daglem/reDIP-64/hardware/reDIP-64.kicad_pcb

## KiCad design hardware/reDIP-64.kicad_pcb (2024-03-09)

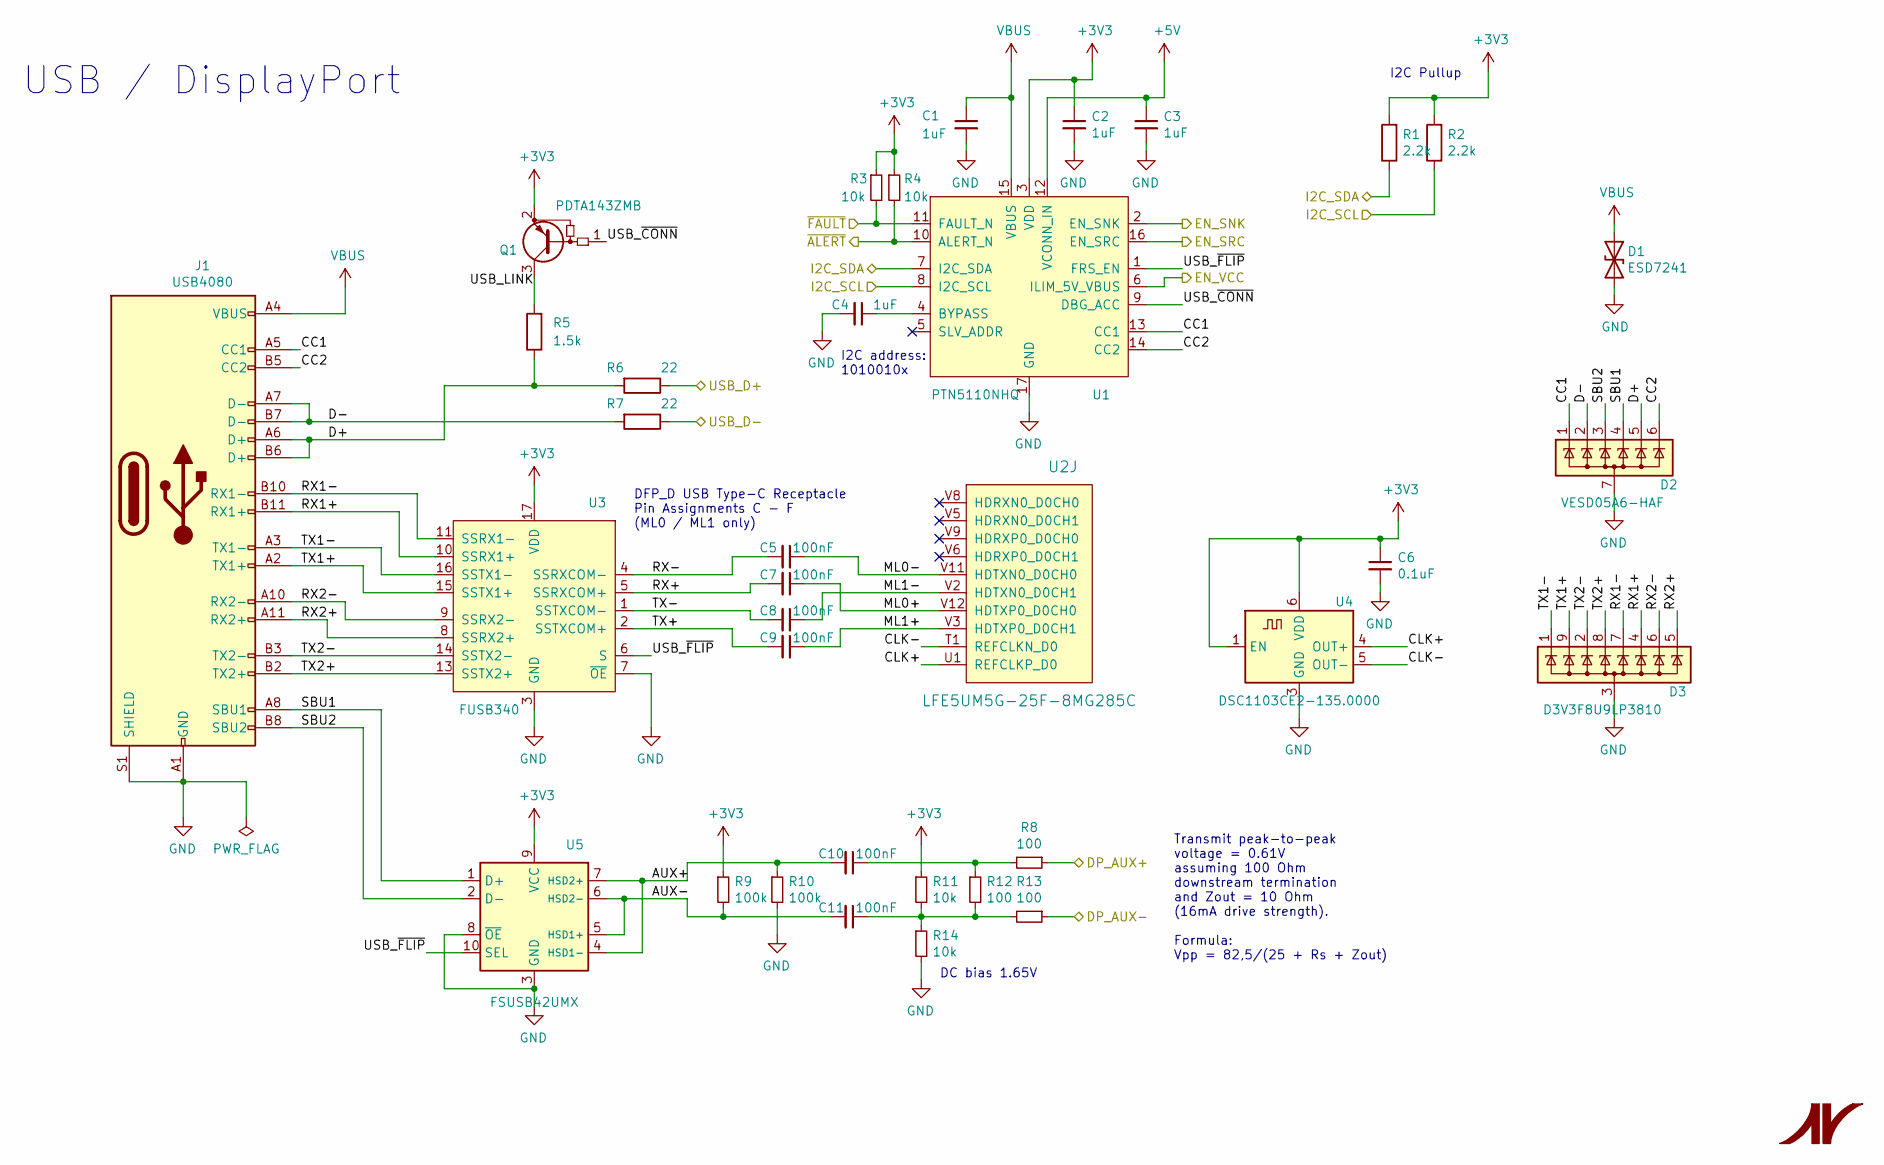
[picture p1: schematic reDIP-64-USB.kicad_sch, reDIP 64]

Parts:
C1: 1uF; C_0402_1005Metric
C2, C3, C4: 1uF; C_0201_0603Metric
C5, C7, C8, C9, C10, C11: 100nF; C_0201_0603Metric
C6: 0.1uF; C_0201_0603Metric
D1: ESD7241; CASE_714AB_1.0x0.6mm
D2: VESD05A6-HAF; LLP75-7L
D3: D3V3F8U9LP3810; U-DFN3810-9
J1: USB4080; USB_C_Receptacle_GCT_USB4080
Q1: PDTA143ZMB; SOT-883
R1, R2: 2.2k; R_0201_0603Metric
R3, R4, R11, R14: 10k; R_0201_0603Metric
R5: 1.5k; R_0201_0603Metric
R6, R7: 22; R_0201_0603Metric
R8, R12, R13: 100; R_0201_0603Metric
R9, R10: 100k; R_0201_0603Metric
U1: PTN5110NHQ; SOT-1883-1
U2: LFE5UM5G-25F-8MG285C; BGA-285_10x10mm_P0.5mm
U3: FUSB340; CASE_722AB_2.0x2.8mm_P0.4mm
U4: DSC1103CE2-135.0000; Oscillator_SMD_3225-6Pin_3.2x2.5mm
U5: FSUSB42UMX; CASE_523BC_1.4x1.8_P0.4mm

Connections:
+3V3: C2.1, C6.1, Q1.2 (E), R1.2, R2.2, R3.1, R4.1, R9.1, R11.1, U1.3 (VDD), U3.17 (VDD), U4.1 (EN), U4.6 (VDD), U5.9 (VCC); also elsewhere on the board
+5V: C3.1, U1.12 (VCONN_IN); also elsewhere on the board
/Audio/I2C_SCL: R2.1, U1.8 (I2C_SCL); also elsewhere on the board
/Audio/I2C_SDA: R1.1, U1.7 (I2C_SDA); also elsewhere on the board
/FPGA_IO/DP_AUX+: R8.1; also elsewhere on the board
/FPGA_IO/DP_AUX-: R13.1; also elsewhere on the board
/FPGA_IO/USB_D+: R6.1; also elsewhere on the board
/FPGA_IO/USB_D-: R7.1; also elsewhere on the board
/FPGA_IO/~ALERT: R4.2, U1.10 (ALERT_N); also elsewhere on the board
/Power/EN_SNK: U1.2 (EN_SNK); also elsewhere on the board
/Power/EN_SRC: U1.16 (EN_SRC); also elsewhere on the board
/Power/EN_VCC: U1.6 (ILIM_5V_VBUS); also elsewhere on the board
/Power/~FAULT: R3.2, U1.11 (FAULT_N); also elsewhere on the board
/USB_DisplayPort/AUX+: C10.2, R10.1, U5.4 (HSD1-), U5.7 (HSD2+)
/USB_DisplayPort/AUX-: C11.2, R9.2, U5.5 (HSD1+), U5.6 (HSD2-)
/USB_DisplayPort/CC1: D2.1 (K), J1.A5 (CC1), U1.13 (CC1)
/USB_DisplayPort/CC2: D2.6 (K), J1.B5 (CC2), U1.14 (CC2)
/USB_DisplayPort/CLK+: U2.U1 (REFCLKP_D0), U4.4 (OUT+)
/USB_DisplayPort/CLK-: U2.T1 (REFCLKN_D0), U4.5 (OUT-)
/USB_DisplayPort/D+: D2.5 (K), J1.A6 (D+), J1.B6 (D+), R5.1, R6.2
/USB_DisplayPort/D-: D2.2 (K), J1.A7 (D-), J1.B7 (D-), R7.2
/USB_DisplayPort/ML0+: C7.1, U2.V12 (HDTXP0_D0CH0)
/USB_DisplayPort/ML0-: C5.1, U2.V11 (HDTXN0_D0CH0)
/USB_DisplayPort/ML1+: C9.1, U2.V3 (HDTXP0_D0CH1)
/USB_DisplayPort/ML1-: C8.1, U2.V2 (HDTXN0_D0CH1)
/USB_DisplayPort/RX1+: D3.4 (Line-6), J1.B11 (RX1+), U3.10 (SSRX1+)
/USB_DisplayPort/RX1-: D3.7 (Line-5), J1.B10 (RX1-), U3.11 (SSRX1-)
/USB_DisplayPort/RX2+: D3.5 (Line-8), J1.A11 (RX2+), U3.8 (SSRX2+)
/USB_DisplayPort/RX2-: D3.6 (Line-7), J1.A10 (RX2-), U3.9 (SSRX2-)
/USB_DisplayPort/RX+: C7.2, U3.5 (SSRXCOM+)
/USB_DisplayPort/RX-: C5.2, U3.4 (SSRXCOM-)
/USB_DisplayPort/SBU1: D2.4 (K), J1.A8 (SBU1), U5.1 (D+)
/USB_DisplayPort/SBU2: D2.3 (K), J1.B8 (SBU2), U5.2 (D-)
/USB_DisplayPort/TX1+: D3.9 (Line-2), J1.A2 (TX1+), U3.15 (SSTX1+)
/USB_DisplayPort/TX1-: D3.1 (Line-1), J1.A3 (TX1-), U3.16 (SSTX1-)
/USB_DisplayPort/TX2+: D3.8 (Line-4), J1.B2 (TX2+), U3.13 (SSTX2+)
/USB_DisplayPort/TX2-: D3.2 (Line-3), J1.B3 (TX2-), U3.14 (SSTX2-)
/USB_DisplayPort/TX+: C9.2, U3.2 (SSTXCOM+)
/USB_DisplayPort/TX-: C8.2, U3.1 (SSTXCOM-)
/USB_DisplayPort/USB_LINK: Q1.3 (C), R5.2
/USB_DisplayPort/USB_~CONN: Q1.1 (B), U1.9 (DBG_ACC)
/USB_DisplayPort/USB_~FLIP: U1.1 (FRS_EN), U3.6 (S), U5.10 (SEL)
GND: C1.2, C2.2, C3.2, C4.2, C6.2, D1.2 (A2), D2.7 (GND), D3.3 (GND), J1.A1 (GND), J1.A12 (GND), J1.B1 (GND), J1.B12 (GND), J1.S1 (SHIELD), R10.2, R14.2, U1.17 (GND), U3.3 (GND), U3.7 (~OE), U3.12 (GND), U3.18 (GND), U3.19 (GND), U4.3 (GND), U5.3 (GND), U5.8 (~OE); also elsewhere on the board
unnamed: C10.1, R8.2, R12.1
unnamed: C11.1, R11.2, R12.2, R13.2, R14.1
unnamed: C4.1, U1.4 (BYPASS)
VBUS: C1.1, D1.1 (A1), J1.A4 (VBUS), J1.A9 (VBUS), J1.B4 (VBUS), J1.B9 (VBUS), U1.15 (VBUS); also elsewhere on the board

Notes on the sheet:
Transmit peak-to-peak voltage = 0.61V assuming 100 Ohm downstream termination and Zout = 10 Ohm (16mA drive strength). Formula: Vpp = 82,5/(25 + Rs + Zout)
USB / DisplayPort
DFP_D USB Type-C Receptacle Pin Assignments C - F (ML0 / ML1 only)
DC bias 1.65V
I2C address: 1010010x
I2C Pullup

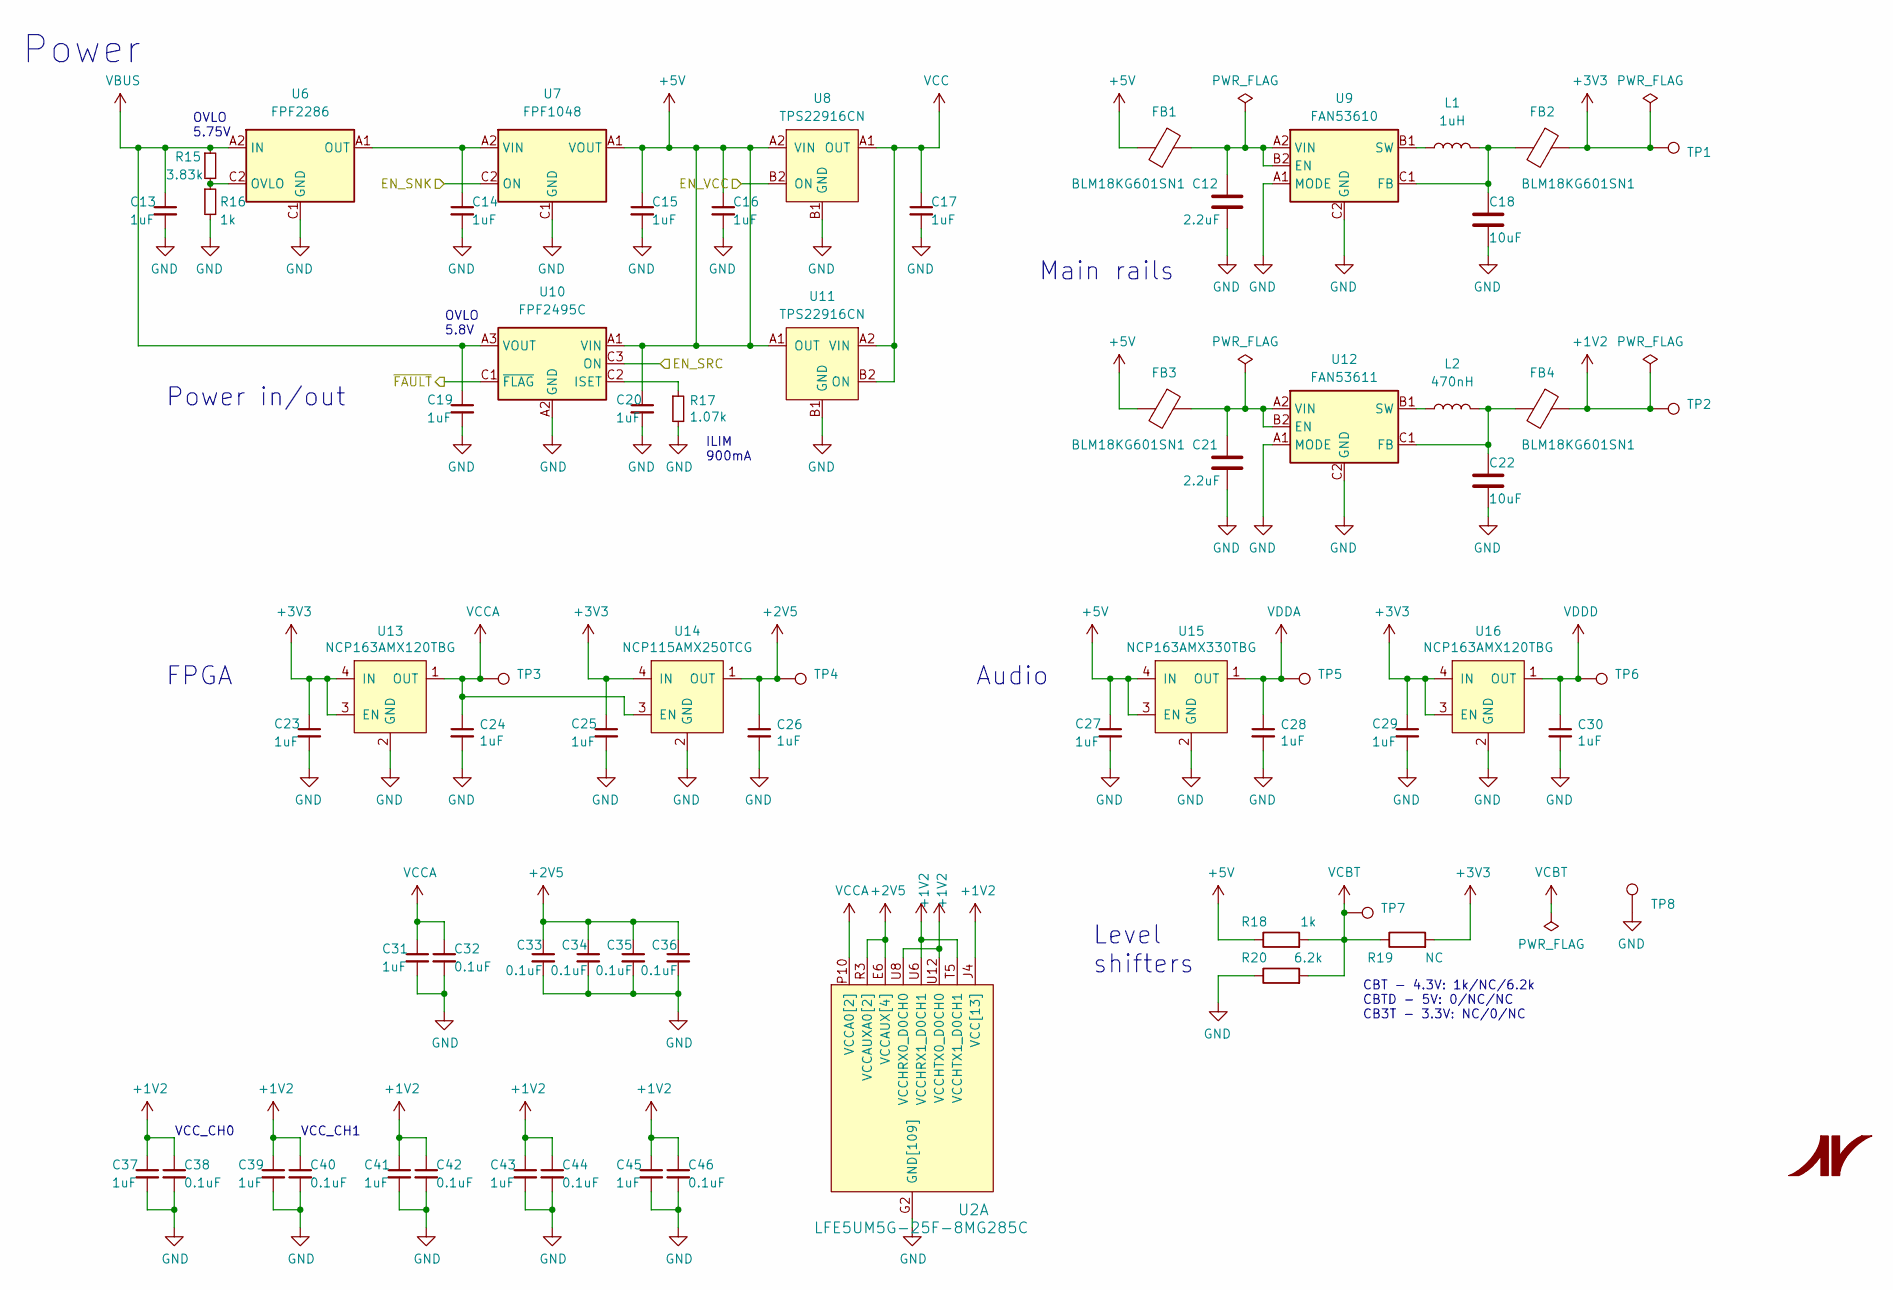
[picture p2: schematic reDIP-64-Power.kicad_sch, reDIP 64]

Parts:
C12, C21: 2.2uF; C_0402_1005Metric
C13, C14, C15, C16, C17, C19, C20, C27: 1uF; C_0402_1005Metric
C18: 10uF; C_0603_1608Metric
C22: 10uF; C_0402_1005Metric
C23, C24, C25, C26, C28, C29, C30, C31, C37, C39, C41, C43, C45: 1uF; C_0201_0603Metric
C32, C33, C34, C35, C36, C38, C40, C42, C44, C46: 0.1uF; C_0201_0603Metric
FB1, FB2, FB3, FB4: BLM18KG601SN1; L_0603_1608Metric
L1: 1uH; L_0603_1608Metric
L2: 470nH; L_0603_1608Metric
R15: 3.83k; R_0201_0603Metric
R16, R18: 1k; R_0201_0603Metric
R17: 1.07k; R_0201_0603Metric
R19: NC; R_0201_0603Metric
R20: 6.2k; R_0201_0603Metric
TP1, TP2, TP3, TP4, TP5, TP6, TP7, TP8: TestPoint; TestPoint_Pad_D0.5mm
U2: LFE5UM5G-25F-8MG285C; BGA-285_10x10mm_P0.5mm
U6: FPF2286; CASE_567UV_1.30x0.90mm_P0.4mm
U7: FPF1048; CASE_567RM_1.46x0.96mm_P0.5mm
U8, U11: TPS22916CN; Texas_DSBGA-4_0.78x0.78mm_Layout2x2_P0.4mm
U9: FAN53610; CASE_567RQ_1.16x0.86mm_P0.4mm
U10: FPF2495C; CASE_567RV_1.21x1.21mm_P0.4mm
U12: FAN53611; CASE_567RQ_1.16x0.86mm_P0.4mm
U13, U16: NCP163AMX120TBG; CASE_711AJ_1.0x1.0mm_P0.65mm
U14: NCP115AMX250TCG; CASE_711AJ_1.0x1.0mm_P0.65mm
U15: NCP163AMX330TBG; CASE_711AJ_1.0x1.0mm_P0.65mm

Connections:
+1V2: C37.1, C38.1, C39.1, C40.1, C41.1, C42.1, C43.1, C44.1, C45.1, C46.1, FB4.1, TP2.1, U2.D8 (VCC[13]), U2.D9 (VCC[13]), U2.D10 (VCC[13]), U2.D11 (VCC[13]), U2.J4 (VCC[13]), U2.J5 (VCC[13]), U2.J14 (VCC[13]), U2.J15 (VCC[13]), U2.M4 (VCC[13]), U2.M15 (VCC[13]), U2.P7 (VCC[13]), U2.P9 (VCC[13]), U2.P11 (VCC[13]), U2.T5 (VCCHTX1_D0CH1), U2.U6 (VCCHRX1_D0CH1), U2.U8 (VCCHRX0_D0CH0), U2.U12 (VCCHTX0_D0CH0)
+2V5: C26.1, C33.1, C34.1, C35.1, C36.1, TP4.1, U2.E6 (VCCAUX[4]), U2.E13 (VCCAUX[4]), U2.N6 (VCCAUX[4]), U2.P5 (VCCAUXA0[2]), U2.P13 (VCCAUX[4]), U2.R3 (VCCAUXA0[2]), U14.1 (OUT)
+3V3: C23.1, C25.1, C29.1, FB2.1, R19.2, TP1.1, U13.3 (EN), U13.4 (IN), U14.4 (IN), U16.3 (EN), U16.4 (IN); also elsewhere on the board
+5V: C15.1, C16.1, C20.1, C27.1, FB1.2, FB3.2, R18.1, U7.A1 (VOUT), U7.B1 (VOUT), U8.A2 (VIN), U10.A1 (VIN), U10.B1 (VIN), U11.A1 (OUT), U15.3 (EN), U15.4 (IN); also elsewhere on the board
/Power/EN_SNK: U7.C2 (ON); also elsewhere on the board
/Power/EN_SRC: U10.C3 (ON); also elsewhere on the board
/Power/EN_VCC: U8.B2 (ON); also elsewhere on the board
/Power/~FAULT: U10.C1 (~FLAG); also elsewhere on the board
GND: C12.2, C13.2, C14.2, C15.2, C16.2, C17.2, C18.2, C19.2, C20.2, C21.2, C22.2, C23.2, C24.2, C25.2, C26.2, C27.2, C28.2, C29.2, C30.2, C31.2, C32.2, C33.2, C34.2, C35.2, C36.2, C37.2, C38.2, C39.2, C40.2, C41.2, C42.2, C43.2, C44.2, C45.2, C46.2, R16.2, R17.2, R20.1, TP8.1, U2.B3 (GND[109]), U2.B16 (GND[109]), U2.E5 (GND[109]), U2.E7 (GND[109]), U2.E8 (GND[109]), U2.E9 (GND[109]), U2.E10 (GND[109]), U2.E11 (GND[109]), U2.E12 (GND[109]), U2.E14 (GND[109]), U2.F5 (GND[109]), U2.F6 (GND[109]), U2.F7 (GND[109]), U2.F8 (GND[109]), U2.F9 (GND[109]), U2.F10 (GND[109]), U2.F11 (GND[109]), U2.F12 (GND[109]), U2.F13 (GND[109]), U2.F14 (GND[109]), U2.G2 (GND[109]), U2.G6 (GND[109]), U2.G7 (GND[109]), U2.G8 (GND[109]), U2.G9 (GND[109]), U2.G10 (GND[109]), U2.G11 (GND[109]), U2.G12 (GND[109]), U2.G13 (GND[109]), U2.G17 (GND[109]), U2.H6 (GND[109]), U2.H7 (GND[109]), U2.H8 (GND[109]), U2.H9 (GND[109]), U2.H10 (GND[109]), U2.H11 (GND[109]), U2.H12 (GND[109]), U2.H13 (GND[109]), U2.J6 (GND[109]), U2.J7 (GND[109]), U2.J8 (GND[109]), U2.J9 (GND[109]), U2.J10 (GND[109]), U2.J11 (GND[109]), U2.J12 (GND[109]), U2.J13 (GND[109]), U2.K5 (GND[109]), U2.K6 (GND[109]), U2.K7 (GND[109]), U2.K8 (GND[109]), U2.K9 (GND[109]), U2.K10 (GND[109]), U2.K11 (GND[109]), U2.K12 (GND[109]), U2.K13 (GND[109]), U2.K14 (GND[109]), U2.L2 (GND[109]), U2.L5 (GND[109]), U2.L6 (GND[109]), U2.L7 (GND[109]), U2.L8 (GND[109]), U2.L9 (GND[109]), U2.L10 (GND[109]), U2.L11 (GND[109]), U2.L12 (GND[109]), U2.L13 (GND[109]), U2.L14 (GND[109]), U2.L17 (GND[109]), U2.M6 (GND[109]), U2.M7 (GND[109]), U2.M8 (GND[109]), U2.M9 (GND[109]), U2.M10 (GND[109]), U2.M11 (GND[109]), U2.M12 (GND[109]), U2.M13 (GND[109]), U2.N7 (GND[109]), U2.N8 (GND[109]), U2.N9 (GND[109]), U2.N10 (GND[109]), U2.N11 (GND[109]), U2.N12 (GND[109]), U2.P6 (GND[109]), U2.P8 (GND[109]), U2.P12 (GND[109]), U2.R1 (GND[109]), U2.R2 (GND[109]), U2.T2 (GND[109]), U2.T3 (GND[109]), U2.T4 (GND[109]), U2.T6 (GND[109]), U2.T7 (GND[109]), U2.T8 (GND[109]), U2.T9 (GND[109]), U2.T10 (GND[109]), U2.T11 (GND[109]), U2.T12 (GND[109]), U2.T16 (GND[109]), U2.U2 (GND[109]), U2.U3 (GND[109]), U2.U4 (GND[109]), U2.U5 (GND[109]), U2.U7 (GND[109]), U2.U9 (GND[109]), U2.U10 (GND[109]), U2.U11 (GND[109]), U2.V4 (GND[109]), U2.V7 (GND[109]), U2.V10 (GND[109]), U6.C1 (GND), U7.C1 (GND), U8.B1 (GND), U9.A1 (MODE), U9.C2 (GND), U10.A2 (GND), U10.B2 (GND), U11.B1 (GND), U12.A1 (MODE), U12.C2 (GND), U13.2 (GND), U14.2 (GND), U15.2 (GND), U16.2 (GND); also elsewhere on the board
unnamed: C14.1, U6.A1 (OUT), U6.B1 (OUT), U7.A2 (VIN), U7.B2 (VIN)
unnamed: R15.2, R16.1, U6.C2 (OVLO)
unnamed: C12.1, FB1.1, U9.A2 (VIN), U9.B2 (EN)
unnamed: C18.1, FB2.2, L1.2, U9.C1 (FB)
unnamed: L1.1, U9.B1 (SW)
unnamed: R17.1, U10.C2 (ISET)
unnamed: C21.1, FB3.1, U12.A2 (VIN), U12.B2 (EN)
unnamed: C22.1, FB4.2, L2.2, U12.C1 (FB)
unnamed: L2.1, U12.B1 (SW)
VBUS: C13.1, C19.1, R15.1, U6.A2 (IN), U6.B2 (IN), U10.A3 (VOUT), U10.B3 (VOUT); also elsewhere on the board
VCBT: R18.2, R19.1, R20.2, TP7.1; also elsewhere on the board
VCC: C17.1, U8.A1 (OUT), U11.A2 (VIN), U11.B2 (ON); also elsewhere on the board
VCCA: C24.1, C31.1, C32.1, TP3.1, U2.P10 (VCCA0[2]), U2.R10 (VCCA0[2]), U13.1 (OUT), U14.3 (EN)
VDDA: C28.1, TP5.1, U15.1 (OUT); also elsewhere on the board
VDDD: C30.1, TP6.1, U16.1 (OUT); also elsewhere on the board

Notes on the sheet:
OVLO 5.8V
Power
VCC_CH1
CBT - 4.3V: 1k/NC/6.2k CBTD - 5V: 0/NC/NC CB3T - 3.3V: NC/0/NC
OVLO 5.75V
ILIM 900mA
VCC_CH0
Power in/out
Audio
FPGA
Main rails
Level shifters

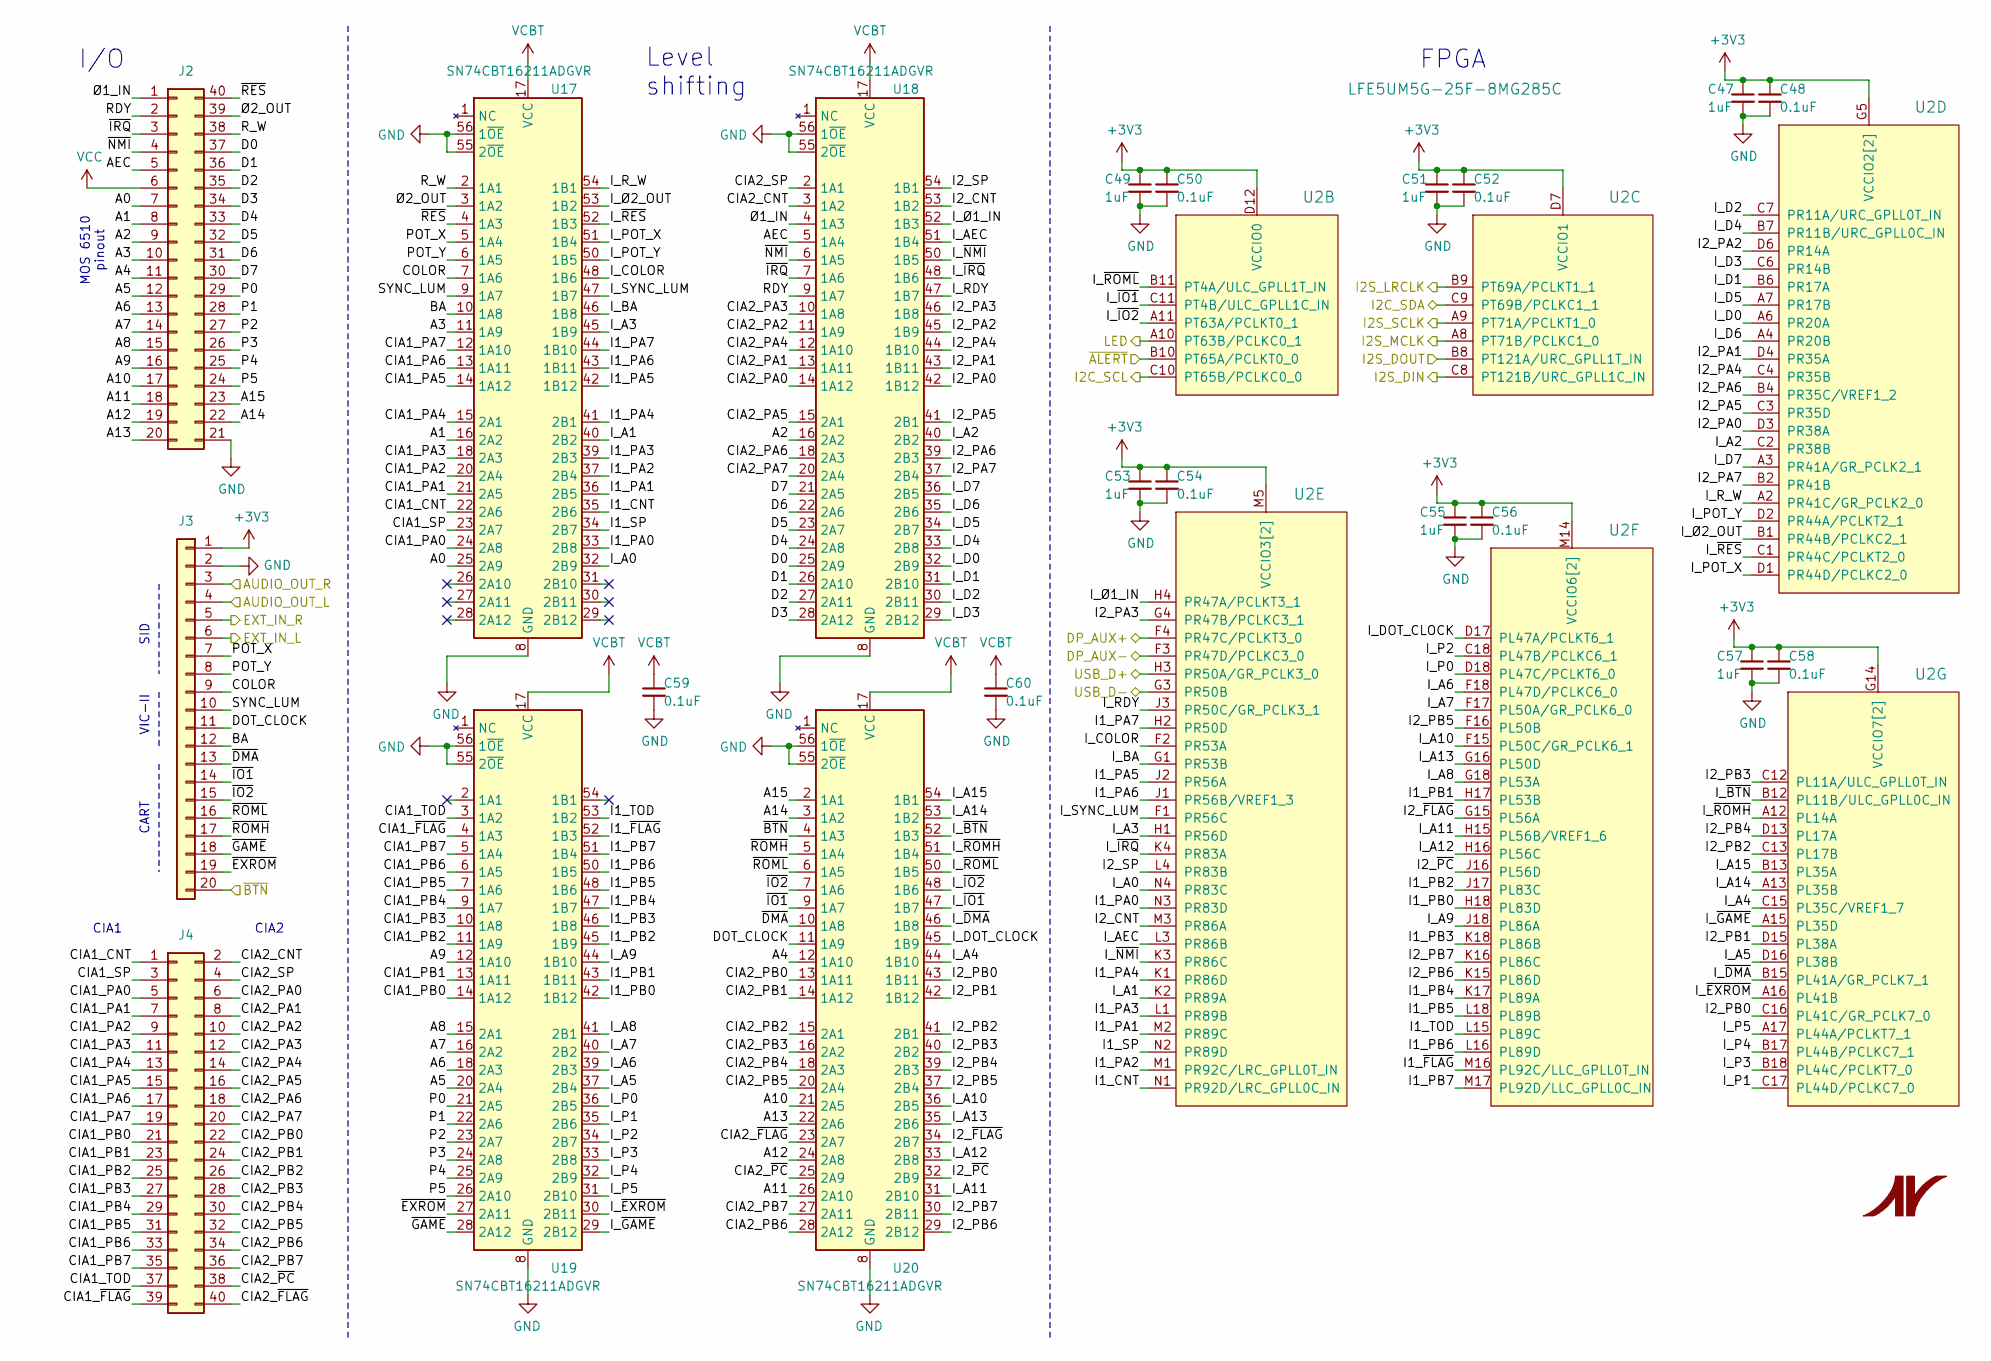
[picture p3: schematic reDIP-64-FPGA.kicad_sch, reDIP 64]

Parts:
C47, C49, C51, C53, C55, C57: 1uF; C_0201_0603Metric
C48, C50, C52, C54, C56, C58, C59, C60: 0.1uF; C_0201_0603Metric
J2: Conn_02x20_Counter_Clockwise; DIP-40_W15.24mm_Header
J3: Conn_01x20; PinHeader_1x20_P2.54mm_Vertical
J4: Conn_02x20_Odd_Even; PinHeader_2x20_P2.54mm_Vertical
U2: LFE5UM5G-25F-8MG285C; BGA-285_10x10mm_P0.5mm
U17, U18, U19, U20: SN74CBT16211ADGVR; Texas_TVSOP-56_4.4x11.3mm_P0.4mm

Connections:
+3V3: C47.1, C48.1, C49.1, C50.1, C51.1, C52.1, C53.1, C54.1, C55.1, C56.1, C57.1, C58.1, J3.1, U2.D7 (VCCIO1), U2.D12 (VCCIO0), U2.G5 (VCCIO2[2]), U2.G14 (VCCIO7[2]), U2.H5 (VCCIO2[2]), U2.H14 (VCCIO7[2]), U2.M5 (VCCIO3[2]), U2.M14 (VCCIO6[2]), U2.N5 (VCCIO3[2]), U2.N14 (VCCIO6[2]); also elsewhere on the board
/Audio/AUDIO_OUT_L: J3.4; also elsewhere on the board
/Audio/AUDIO_OUT_R: J3.3; also elsewhere on the board
/Audio/EXT_IN_L: J3.6; also elsewhere on the board
/Audio/EXT_IN_R: J3.5; also elsewhere on the board
/Audio/I2C_SCL: U2.C10 (PT65B/PCLKC0_0); also elsewhere on the board
/Audio/I2C_SDA: U2.C9 (PT69B/PCLKC1_1); also elsewhere on the board
/Audio/I2S_DIN: U2.C8 (PT121B/URC_GPLL1C_IN); also elsewhere on the board
/Audio/I2S_DOUT: U2.B8 (PT121A/URC_GPLL1T_IN); also elsewhere on the board
/Audio/I2S_LRCLK: U2.B9 (PT69A/PCLKT1_1); also elsewhere on the board
/Audio/I2S_MCLK: U2.A8 (PT71B/PCLKC1_0); also elsewhere on the board
/Audio/I2S_SCLK: U2.A9 (PT71A/PCLKT1_0); also elsewhere on the board
/Config_Memory/LED: U2.A10 (PT63B/PCLKC0_1); also elsewhere on the board
/FPGA_IO/A0: J2.7, U17.25 (2A9)
/FPGA_IO/A1: J2.8, U17.16 (2A2)
/FPGA_IO/A2: J2.9, U18.16 (2A2)
/FPGA_IO/A3: J2.10, U17.11 (1A9)
/FPGA_IO/A4: J2.11, U20.12 (1A10)
/FPGA_IO/A5: J2.12, U19.20 (2A4)
/FPGA_IO/A6: J2.13, U19.18 (2A3)
/FPGA_IO/A7: J2.14, U19.16 (2A2)
/FPGA_IO/A8: J2.15, U19.15 (2A1)
/FPGA_IO/A9: J2.16, U19.12 (1A10)
/FPGA_IO/A10: J2.17, U20.21 (2A5)
/FPGA_IO/A11: J2.18, U20.26 (2A10)
/FPGA_IO/A12: J2.19, U20.24 (2A8)
/FPGA_IO/A13: J2.20, U20.22 (2A6)
/FPGA_IO/A14: J2.22, U20.3 (1A2)
/FPGA_IO/A15: J2.23, U20.2 (1A1)
/FPGA_IO/AEC: J2.5, U18.5 (1A4)
/FPGA_IO/BA: J3.12, U17.10 (1A8)
/FPGA_IO/CIA1_CNT: J4.1, U17.22 (2A6)
/FPGA_IO/CIA1_PA0: J4.5, U17.24 (2A8)
/FPGA_IO/CIA1_PA1: J4.7, U17.21 (2A5)
/FPGA_IO/CIA1_PA2: J4.9, U17.20 (2A4)
/FPGA_IO/CIA1_PA3: J4.11, U17.18 (2A3)
/FPGA_IO/CIA1_PA4: J4.13, U17.15 (2A1)
/FPGA_IO/CIA1_PA5: J4.15, U17.14 (1A12)
/FPGA_IO/CIA1_PA6: J4.17, U17.13 (1A11)
/FPGA_IO/CIA1_PA7: J4.19, U17.12 (1A10)
/FPGA_IO/CIA1_PB0: J4.21, U19.14 (1A12)
/FPGA_IO/CIA1_PB1: J4.23, U19.13 (1A11)
/FPGA_IO/CIA1_PB2: J4.25, U19.11 (1A9)
/FPGA_IO/CIA1_PB3: J4.27, U19.10 (1A8)
/FPGA_IO/CIA1_PB4: J4.29, U19.9 (1A7)
/FPGA_IO/CIA1_PB5: J4.31, U19.7 (1A6)
/FPGA_IO/CIA1_PB6: J4.33, U19.6 (1A5)
/FPGA_IO/CIA1_PB7: J4.35, U19.5 (1A4)
/FPGA_IO/CIA1_SP: J4.3, U17.23 (2A7)
/FPGA_IO/CIA1_TOD: J4.37, U19.3 (1A2)
/FPGA_IO/CIA1_~FLAG: J4.39, U19.4 (1A3)
/FPGA_IO/CIA2_CNT: J4.2, U18.3 (1A2)
/FPGA_IO/CIA2_PA0: J4.6, U18.14 (1A12)
/FPGA_IO/CIA2_PA1: J4.8, U18.13 (1A11)
/FPGA_IO/CIA2_PA2: J4.10, U18.11 (1A9)
/FPGA_IO/CIA2_PA3: J4.12, U18.10 (1A8)
/FPGA_IO/CIA2_PA4: J4.14, U18.12 (1A10)
/FPGA_IO/CIA2_PA5: J4.16, U18.15 (2A1)
/FPGA_IO/CIA2_PA6: J4.18, U18.18 (2A3)
/FPGA_IO/CIA2_PA7: J4.20, U18.20 (2A4)
/FPGA_IO/CIA2_PB0: J4.22, U20.13 (1A11)
/FPGA_IO/CIA2_PB1: J4.24, U20.14 (1A12)
/FPGA_IO/CIA2_PB2: J4.26, U20.15 (2A1)
/FPGA_IO/CIA2_PB3: J4.28, U20.16 (2A2)
/FPGA_IO/CIA2_PB4: J4.30, U20.18 (2A3)
/FPGA_IO/CIA2_PB5: J4.32, U20.20 (2A4)
/FPGA_IO/CIA2_PB6: J4.34, U20.28 (2A12)
/FPGA_IO/CIA2_PB7: J4.36, U20.27 (2A11)
/FPGA_IO/CIA2_SP: J4.4, U18.2 (1A1)
/FPGA_IO/CIA2_~FLAG: J4.40, U20.23 (2A7)
/FPGA_IO/CIA2_~PC: J4.38, U20.25 (2A9)
/FPGA_IO/COLOR: J3.9, U17.7 (1A6)
/FPGA_IO/D0: J2.37, U18.25 (2A9)
/FPGA_IO/D1: J2.36, U18.26 (2A10)
/FPGA_IO/D2: J2.35, U18.27 (2A11)
/FPGA_IO/D3: J2.34, U18.28 (2A12)
/FPGA_IO/D4: J2.33, U18.24 (2A8)
/FPGA_IO/D5: J2.32, U18.23 (2A7)
/FPGA_IO/D6: J2.31, U18.22 (2A6)
/FPGA_IO/D7: J2.30, U18.21 (2A5)
/FPGA_IO/DOT_CLOCK: J3.11, U20.11 (1A9)
/FPGA_IO/DP_AUX+: U2.F4 (PR47C/PCLKT3_0); also elsewhere on the board
/FPGA_IO/DP_AUX-: U2.F3 (PR47D/PCLKC3_0); also elsewhere on the board
/FPGA_IO/I1_CNT: U2.N1 (PR92D/LRC_GPLL0C_IN), U17.35 (2B6)
/FPGA_IO/I1_PA0: U2.N3 (PR83D), U17.33 (2B8)
/FPGA_IO/I1_PA1: U2.M2 (PR89C), U17.36 (2B5)
/FPGA_IO/I1_PA2: U2.M1 (PR92C/LRC_GPLL0T_IN), U17.37 (2B4)
/FPGA_IO/I1_PA3: U2.L1 (PR89B), U17.39 (2B3)
/FPGA_IO/I1_PA4: U2.K1 (PR86D), U17.41 (2B1)
/FPGA_IO/I1_PA5: U2.J2 (PR56A), U17.42 (1B12)
/FPGA_IO/I1_PA6: U2.J1 (PR56B/VREF1_3), U17.43 (1B11)
/FPGA_IO/I1_PA7: U2.H2 (PR50D), U17.44 (1B10)
/FPGA_IO/I1_PB0: U2.H18 (PL83D), U19.42 (1B12)
/FPGA_IO/I1_PB1: U2.H17 (PL53B), U19.43 (1B11)
/FPGA_IO/I1_PB2: U2.J17 (PL83C), U19.45 (1B9)
/FPGA_IO/I1_PB3: U2.K18 (PL86B), U19.46 (1B8)
/FPGA_IO/I1_PB4: U2.K17 (PL89A), U19.47 (1B7)
/FPGA_IO/I1_PB5: U2.L18 (PL89B), U19.48 (1B6)
/FPGA_IO/I1_PB6: U2.L16 (PL89D), U19.50 (1B5)
/FPGA_IO/I1_PB7: U2.M17 (PL92D/LLC_GPLL0C_IN), U19.51 (1B4)
/FPGA_IO/I1_SP: U2.N2 (PR89D), U17.34 (2B7)
/FPGA_IO/I1_TOD: U2.L15 (PL89C), U19.53 (1B2)
/FPGA_IO/I1_~FLAG: U2.M16 (PL92C/LLC_GPLL0T_IN), U19.52 (1B3)
/FPGA_IO/I2_CNT: U2.M3 (PR86A), U18.53 (1B2)
/FPGA_IO/I2_PA0: U2.D3 (PR38A), U18.42 (1B12)
/FPGA_IO/I2_PA1: U2.D4 (PR35A), U18.43 (1B11)
/FPGA_IO/I2_PA2: U2.D6 (PR14A), U18.45 (1B9)
/FPGA_IO/I2_PA3: U2.G4 (PR47B/PCLKC3_1), U18.46 (1B8)
/FPGA_IO/I2_PA4: U2.C4 (PR35B), U18.44 (1B10)
/FPGA_IO/I2_PA5: U2.C3 (PR35D), U18.41 (2B1)
/FPGA_IO/I2_PA6: U2.B4 (PR35C/VREF1_2), U18.39 (2B3)
/FPGA_IO/I2_PA7: U2.B2 (PR41B), U18.37 (2B4)
/FPGA_IO/I2_PB0: U2.C16 (PL41C/GR_PCLK7_0), U20.43 (1B11)
/FPGA_IO/I2_PB1: U2.D15 (PL38A), U20.42 (1B12)
/FPGA_IO/I2_PB2: U2.C13 (PL17B), U20.41 (2B1)
/FPGA_IO/I2_PB3: U2.C12 (PL11A/ULC_GPLL0T_IN), U20.40 (2B2)
/FPGA_IO/I2_PB4: U2.D13 (PL17A), U20.39 (2B3)
/FPGA_IO/I2_PB5: U2.F16 (PL50B), U20.37 (2B4)
/FPGA_IO/I2_PB6: U2.K15 (PL86D), U20.29 (2B12)
/FPGA_IO/I2_PB7: U2.K16 (PL86C), U20.30 (2B11)
/FPGA_IO/I2_SP: U2.L4 (PR83B), U18.54 (1B1)
/FPGA_IO/I2_~FLAG: U2.G15 (PL56A), U20.34 (2B7)
/FPGA_IO/I2_~PC: U2.J16 (PL56D), U20.32 (2B9)
/FPGA_IO/I_A0: U2.N4 (PR83C), U17.32 (2B9)
/FPGA_IO/I_A1: U2.K2 (PR89A), U17.40 (2B2)
/FPGA_IO/I_A2: U2.C2 (PR38B), U18.40 (2B2)
/FPGA_IO/I_A3: U2.H1 (PR56D), U17.45 (1B9)
/FPGA_IO/I_A4: U2.C15 (PL35C/VREF1_7), U20.44 (1B10)
/FPGA_IO/I_A5: U2.D16 (PL38B), U19.37 (2B4)
/FPGA_IO/I_A6: U2.F18 (PL47D/PCLKC6_0), U19.39 (2B3)
/FPGA_IO/I_A7: U2.F17 (PL50A/GR_PCLK6_0), U19.40 (2B2)
/FPGA_IO/I_A8: U2.G18 (PL53A), U19.41 (2B1)
/FPGA_IO/I_A9: U2.J18 (PL86A), U19.44 (1B10)
/FPGA_IO/I_A10: U2.F15 (PL50C/GR_PCLK6_1), U20.36 (2B5)
/FPGA_IO/I_A11: U2.H15 (PL56B/VREF1_6), U20.31 (2B10)
/FPGA_IO/I_A12: U2.H16 (PL56C), U20.33 (2B8)
/FPGA_IO/I_A13: U2.G16 (PL50D), U20.35 (2B6)
/FPGA_IO/I_A14: U2.A13 (PL35B), U20.53 (1B2)
/FPGA_IO/I_A15: U2.B13 (PL35A), U20.54 (1B1)
/FPGA_IO/I_AEC: U2.L3 (PR86B), U18.51 (1B4)
/FPGA_IO/I_BA: U2.G1 (PR53B), U17.46 (1B8)
/FPGA_IO/I_COLOR: U2.F2 (PR53A), U17.48 (1B6)
/FPGA_IO/I_D0: U2.A6 (PR20A), U18.32 (2B9)
/FPGA_IO/I_D1: U2.B6 (PR17A), U18.31 (2B10)
/FPGA_IO/I_D2: U2.C7 (PR11A/URC_GPLL0T_IN), U18.30 (2B11)
/FPGA_IO/I_D3: U2.C6 (PR14B), U18.29 (2B12)
/FPGA_IO/I_D4: U2.B7 (PR11B/URC_GPLL0C_IN), U18.33 (2B8)
/FPGA_IO/I_D5: U2.A7 (PR17B), U18.34 (2B7)
/FPGA_IO/I_D6: U2.A4 (PR20B), U18.35 (2B6)
/FPGA_IO/I_D7: U2.A3 (PR41A/GR_PCLK2_1), U18.36 (2B5)
/FPGA_IO/I_DOT_CLOCK: U2.D17 (PL47A/PCLKT6_1), U20.45 (1B9)
/FPGA_IO/I_P0: U2.D18 (PL47C/PCLKT6_0), U19.36 (2B5)
/FPGA_IO/I_P1: U2.C17 (PL44D/PCLKC7_0), U19.35 (2B6)
/FPGA_IO/I_P2: U2.C18 (PL47B/PCLKC6_1), U19.34 (2B7)
/FPGA_IO/I_P3: U2.B18 (PL44C/PCLKT7_0), U19.33 (2B8)
/FPGA_IO/I_P4: U2.B17 (PL44B/PCLKC7_1), U19.32 (2B9)
/FPGA_IO/I_P5: U2.A17 (PL44A/PCLKT7_1), U19.31 (2B10)
/FPGA_IO/I_POT_X: U2.D1 (PR44D/PCLKC2_0), U17.51 (1B4)
/FPGA_IO/I_POT_Y: U2.D2 (PR44A/PCLKT2_1), U17.50 (1B5)
/FPGA_IO/I_RDY: U2.J3 (PR50C/GR_PCLK3_1), U18.47 (1B7)
/FPGA_IO/I_R_W: U2.A2 (PR41C/GR_PCLK2_0), U17.54 (1B1)
/FPGA_IO/I_SYNC_LUM: U2.F1 (PR56C), U17.47 (1B7)
/FPGA_IO/I_~BTN: U2.B12 (PL11B/ULC_GPLL0C_IN), U20.52 (1B3)
/FPGA_IO/I_~DMA: U2.B15 (PL41A/GR_PCLK7_1), U20.46 (1B8)
/FPGA_IO/I_~EXROM: U2.A16 (PL41B), U19.30 (2B11)
/FPGA_IO/I_~GAME: U2.A15 (PL35D), U19.29 (2B12)
/FPGA_IO/I_~IO1: U2.C11 (PT4B/ULC_GPLL1C_IN), U20.47 (1B7)
/FPGA_IO/I_~IO2: U2.A11 (PT63A/PCLKT0_1), U20.48 (1B6)
/FPGA_IO/I_~IRQ: U2.K4 (PR83A), U18.48 (1B6)
/FPGA_IO/I_~NMI: U2.K3 (PR86C), U18.50 (1B5)
/FPGA_IO/I_~RES: U2.C1 (PR44C/PCLKT2_0), U17.52 (1B3)
/FPGA_IO/I_~ROMH: U2.A12 (PL14A), U20.51 (1B4)
/FPGA_IO/I_~ROML: U2.B11 (PT4A/ULC_GPLL1T_IN), U20.50 (1B5)
/FPGA_IO/I_Ø1_IN: U2.H4 (PR47A/PCLKT3_1), U18.52 (1B3)
/FPGA_IO/I_Ø2_OUT: U2.B1 (PR44B/PCLKC2_1), U17.53 (1B2)
/FPGA_IO/P0: J2.29, U19.21 (2A5)
/FPGA_IO/P1: J2.28, U19.22 (2A6)
/FPGA_IO/P2: J2.27, U19.23 (2A7)
/FPGA_IO/P3: J2.26, U19.24 (2A8)
/FPGA_IO/P4: J2.25, U19.25 (2A9)
/FPGA_IO/P5: J2.24, U19.26 (2A10)
/FPGA_IO/POT_X: J3.7, U17.5 (1A4)
/FPGA_IO/POT_Y: J3.8, U17.6 (1A5)
/FPGA_IO/RDY: J2.2, U18.9 (1A7)
/FPGA_IO/R_W: J2.38, U17.2 (1A1)
/FPGA_IO/SYNC_LUM: J3.10, U17.9 (1A7)
/FPGA_IO/USB_D+: U2.H3 (PR50A/GR_PCLK3_0); also elsewhere on the board
/FPGA_IO/USB_D-: U2.G3 (PR50B); also elsewhere on the board
/FPGA_IO/~ALERT: U2.B10 (PT65A/PCLKT0_0); also elsewhere on the board
/FPGA_IO/~BTN: J3.20, U20.4 (1A3); also elsewhere on the board
/FPGA_IO/~DMA: J3.13, U20.10 (1A8)
/FPGA_IO/~EXROM: J3.19, U19.27 (2A11)
/FPGA_IO/~GAME: J3.18, U19.28 (2A12)
/FPGA_IO/~IO1: J3.14, U20.9 (1A7)
/FPGA_IO/~IO2: J3.15, U20.7 (1A6)
/FPGA_IO/~IRQ: J2.3, U18.7 (1A6)
/FPGA_IO/~NMI: J2.4, U18.6 (1A5)
/FPGA_IO/~RES: J2.40, U17.4 (1A3)
/FPGA_IO/~ROMH: J3.17, U20.5 (1A4)
/FPGA_IO/~ROML: J3.16, U20.6 (1A5)
/FPGA_IO/Ø1_IN: J2.1, U18.4 (1A3)
/FPGA_IO/Ø2_OUT: J2.39, U17.3 (1A2)
GND: C47.2, C48.2, C49.2, C50.2, C51.2, C52.2, C53.2, C54.2, C55.2, C56.2, C57.2, C58.2, C59.2, C60.2, J2.21, J3.2, U17.8 (GND), U17.19 (GND), U17.38 (GND), U17.49 (GND), U17.55 (2~OE), U17.56 (1~OE), U18.8 (GND), U18.19 (GND), U18.38 (GND), U18.49 (GND), U18.55 (2~OE), U18.56 (1~OE), U19.8 (GND), U19.19 (GND), U19.38 (GND), U19.49 (GND), U19.55 (2~OE), U19.56 (1~OE), U20.8 (GND), U20.19 (GND), U20.38 (GND), U20.49 (GND), U20.55 (2~OE), U20.56 (1~OE); also elsewhere on the board
VCBT: C59.1, C60.1, U17.17 (VCC), U18.17 (VCC), U19.17 (VCC), U20.17 (VCC); also elsewhere on the board
VCC: J2.6; also elsewhere on the board

Notes on the sheet:
VIC-II
CIA1
FPGA
I/O
MOS 6510 pinout
SID
CIA2
CART
Level shifting

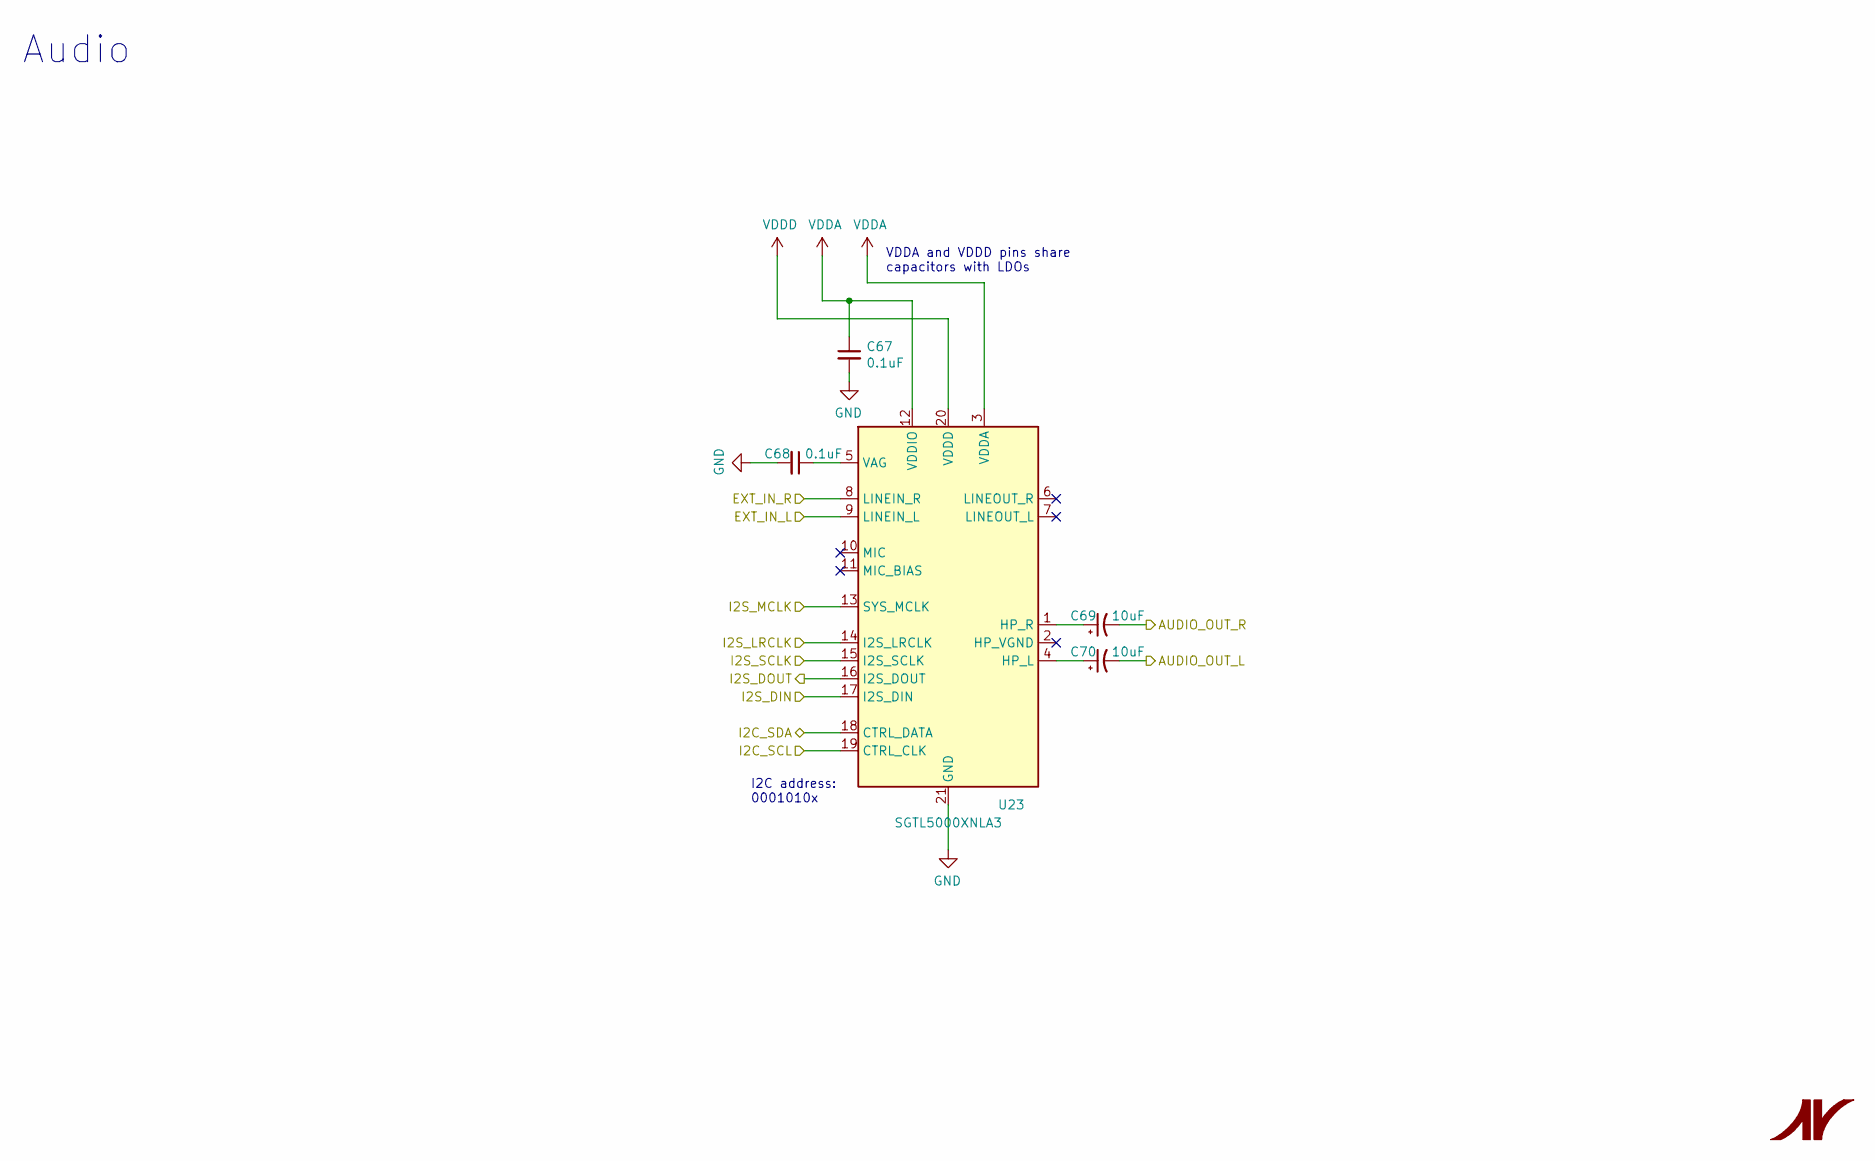
[picture p4: schematic reDIP-64-Audio.kicad_sch, reDIP 64]

Parts:
C67, C68: 0.1uF; C_0201_0603Metric
C69, C70: 10uF; CP_EIA-1608-08_AVX-J
U23: SGTL5000XNLA3; QFN-20-1EP_3x3mm_P0.4mm_EP1.65x1.65mm

Connections:
/Audio/AUDIO_OUT_L: C70.2; also elsewhere on the board
/Audio/AUDIO_OUT_R: C69.2; also elsewhere on the board
/Audio/EXT_IN_L: U23.9 (LINEIN_L); also elsewhere on the board
/Audio/EXT_IN_R: U23.8 (LINEIN_R); also elsewhere on the board
/Audio/I2C_SCL: U23.19 (CTRL_CLK); also elsewhere on the board
/Audio/I2C_SDA: U23.18 (CTRL_DATA); also elsewhere on the board
/Audio/I2S_DIN: U23.17 (I2S_DIN); also elsewhere on the board
/Audio/I2S_DOUT: U23.16 (I2S_DOUT); also elsewhere on the board
/Audio/I2S_LRCLK: U23.14 (I2S_LRCLK); also elsewhere on the board
/Audio/I2S_MCLK: U23.13 (SYS_MCLK); also elsewhere on the board
/Audio/I2S_SCLK: U23.15 (I2S_SCLK); also elsewhere on the board
GND: C67.2, C68.2, U23.21 (GND); also elsewhere on the board
unnamed: C70.1, U23.4 (HP_L)
unnamed: C69.1, U23.1 (HP_R)
unnamed: C68.1, U23.5 (VAG)
VDDA: C67.1, U23.3 (VDDA), U23.12 (VDDIO); also elsewhere on the board
VDDD: U23.20 (VDDD); also elsewhere on the board

Notes on the sheet:
VDDA and VDDD pins share capacitors with LDOs
I2C address: 0001010x
Audio
