daglem/reDIP-64/hardware/reDIP-64.kicad_pcb

## KiCad design hardware/reDIP-64.kicad_pcb (continued)

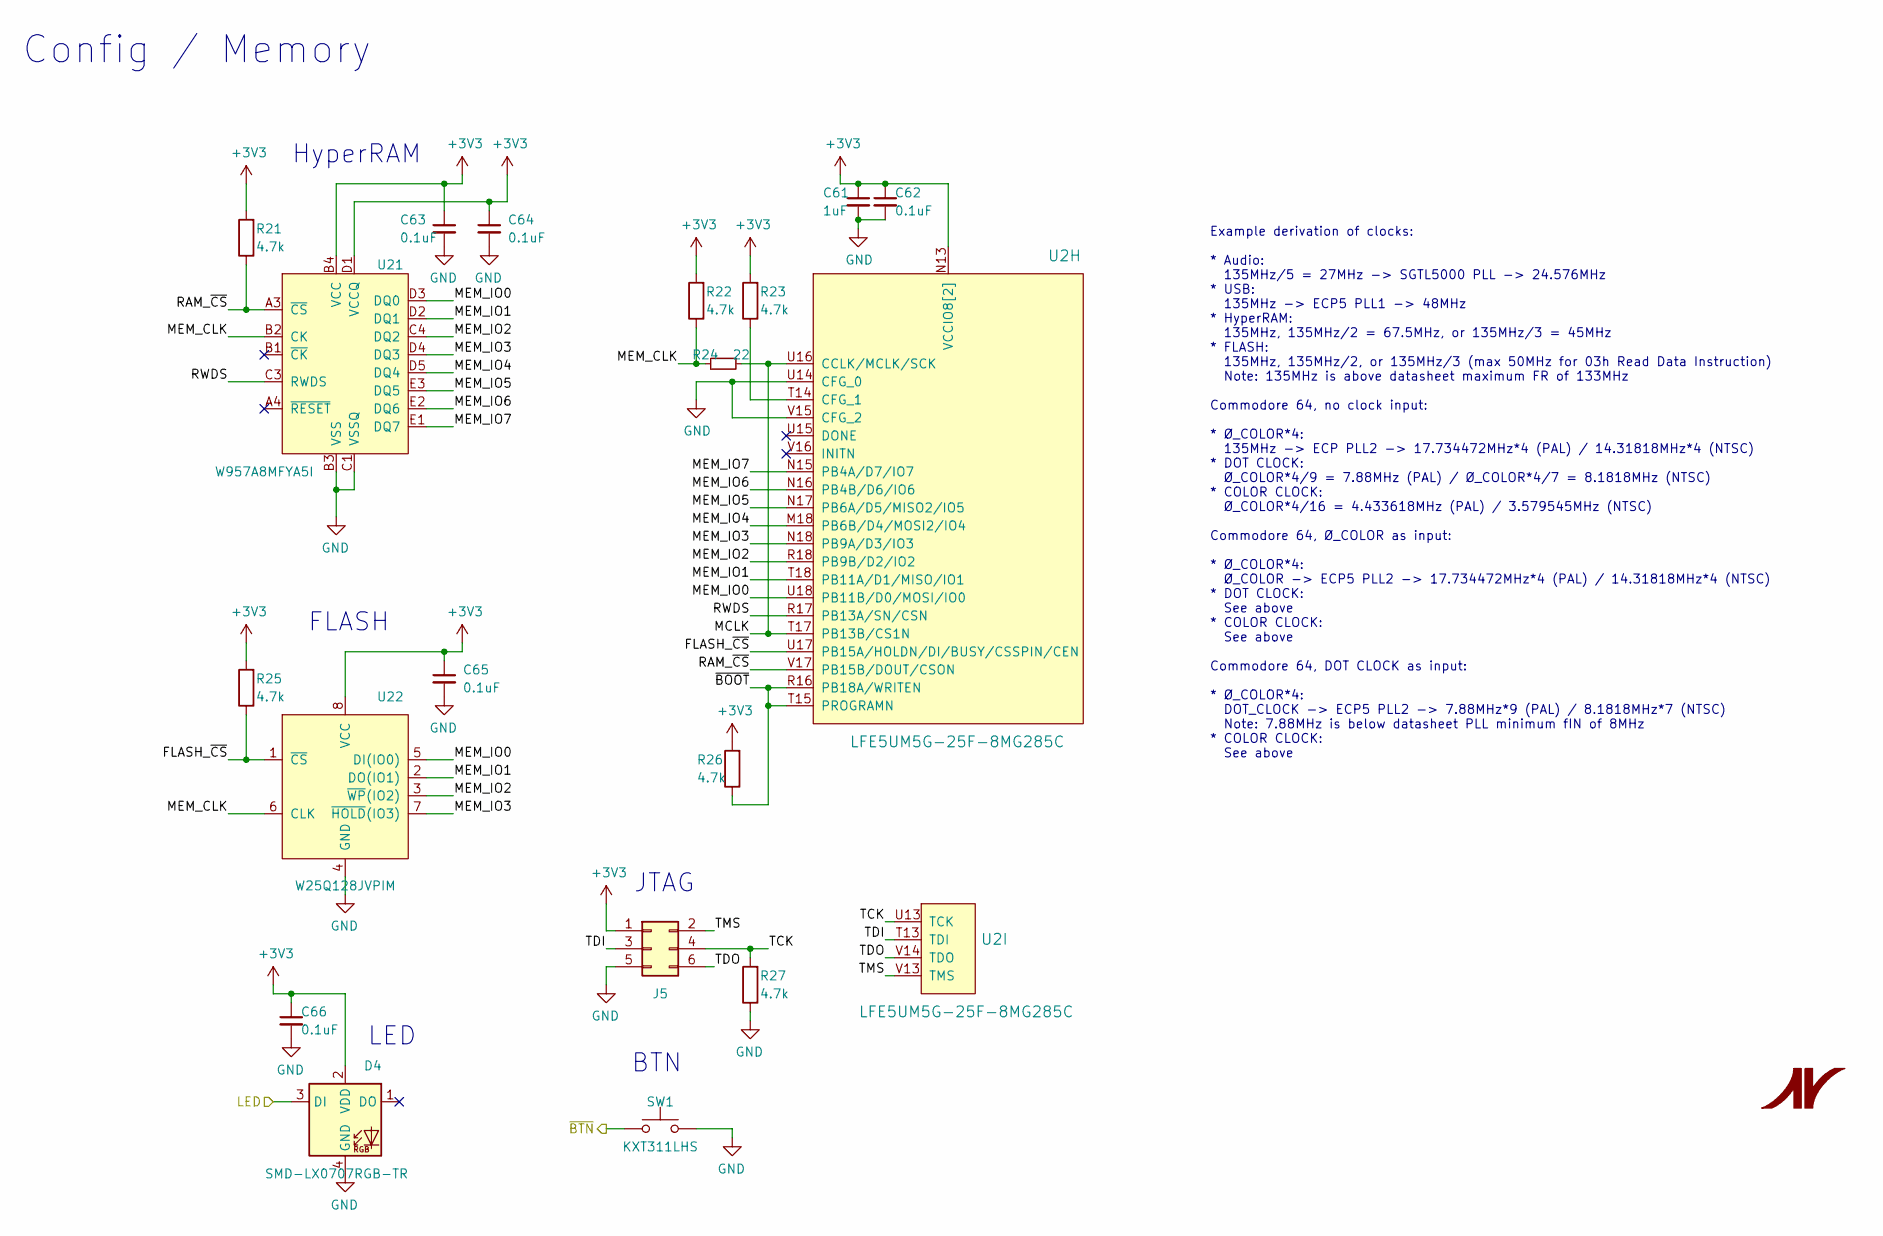
[picture p5: schematic reDIP-64-Config.kicad_sch, reDIP 64]

Parts:
C61: 1uF; C_0201_0603Metric
C62, C63, C64, C65, C66: 0.1uF; C_0201_0603Metric
D4: SMD-LX0707RGB-TR
J5: Conn_02x05_Odd_Even; PinHeader_2x03_P1.27mm_Vertical
R21, R22, R23, R25, R26, R27: 4.7k; R_0201_0603Metric
R24: 22; R_0201_0603Metric
SW1: KXT311LHS; SW_SPST_CK_KXT3
U2: LFE5UM5G-25F-8MG285C; BGA-285_10x10mm_P0.5mm
U21: W957A8MFYA5I; TFBGA-24_6.0x8.0mm_P1mm
U22: W25Q128JVPIM; WSON-8-1EP_6x5mm_P1.27mm_EP3.4x4.3mm

Connections:
+3V3: C61.1, C62.1, C63.1, C64.1, C65.1, C66.1, D4.2 (VDD), J5.1, R21.2, R22.2, R23.2, R25.2, R26.2, U2.N13 (VCCIO8[2]), U2.P14 (VCCIO8[2]), U21.B4 (VCC), U21.D1 (VCCQ), U21.E4 (VCCQ), U22.8 (VCC); also elsewhere on the board
/Config_Memory/FLASH_~CS: R25.1, U2.U17 (PB15A/HOLDN/DI/BUSY/CSSPIN/CEN), U22.1 (~CS)
/Config_Memory/LED: D4.3 (DI); also elsewhere on the board
/Config_Memory/MCLK: R24.1, U2.T17 (PB13B/CS1N), U2.U16 (CCLK/MCLK/SCK)
/Config_Memory/MEM_CLK: R22.1, R24.2, U21.B2 (CK), U22.6 (CLK)
/Config_Memory/MEM_IO0: U2.U18 (PB11B/D0/MOSI/IO0), U21.D3 (DQ0), U22.5 (DI(IO0))
/Config_Memory/MEM_IO1: U2.T18 (PB11A/D1/MISO/IO1), U21.D2 (DQ1), U22.2 (DO(IO1))
/Config_Memory/MEM_IO2: U2.R18 (PB9B/D2/IO2), U21.C4 (DQ2), U22.3 (~WP(IO2))
/Config_Memory/MEM_IO3: U2.N18 (PB9A/D3/IO3), U21.D4 (DQ3), U22.7 (~HOLD(IO3))
/Config_Memory/MEM_IO4: U2.M18 (PB6B/D4/MOSI2/IO4), U21.D5 (DQ4)
/Config_Memory/MEM_IO5: U2.N17 (PB6A/D5/MISO2/IO5), U21.E3 (DQ5)
/Config_Memory/MEM_IO6: U2.N16 (PB4B/D6/IO6), U21.E2 (DQ6)
/Config_Memory/MEM_IO7: U2.N15 (PB4A/D7/IO7), U21.E1 (DQ7)
/Config_Memory/RAM_~CS: R21.1, U2.V17 (PB15B/DOUT/CSON), U21.A3 (~CS)
/Config_Memory/RWDS: U2.R17 (PB13A/SN/CSN), U21.C3 (RWDS)
/Config_Memory/TCK: J5.4, R27.2, U2.U13 (TCK)
/Config_Memory/TDI: J5.3, U2.T13 (TDI)
/Config_Memory/TDO: J5.6, U2.V14 (TDO)
/Config_Memory/TMS: J5.2, U2.V13 (TMS)
/Config_Memory/~BOOT: R26.1, U2.R16 (PB18A/WRITEN), U2.T15 (PROGRAMN)
/FPGA_IO/~BTN: SW1.1; also elsewhere on the board
GND: C61.2, C62.2, C63.2, C64.2, C65.2, C66.2, D4.4 (GND), J5.5, R27.1, SW1.2, U2.U14 (CFG_0), U2.V15 (CFG_2), U21.B3 (VSS), U21.C1 (VSSQ), U21.E5 (VSSQ), U22.4 (GND), U22.9 (GND); also elsewhere on the board
unnamed: R23.1, U2.T14 (CFG_1)

Notes on the sheet:
HyperRAM
FLASH
Config / Memory
Example derivation of clocks: * Audio: 135MHz/5 = 27MHz -> SGTL5000 PLL -> 24.576MHz * USB: 135MHz -> ECP5 PLL1 -> 48MHz * HyperRAM: 135MHz, 135MHz/2 = 67.5MHz, or 135MHz/3 = 45MHz * FLASH: 135MHz, 135MHz/2, or 135MHz/3 (max 50MHz for 03h Read Data Instruction) Note: 135MHz is above datasheet maxim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
JTAG
BTN
LED

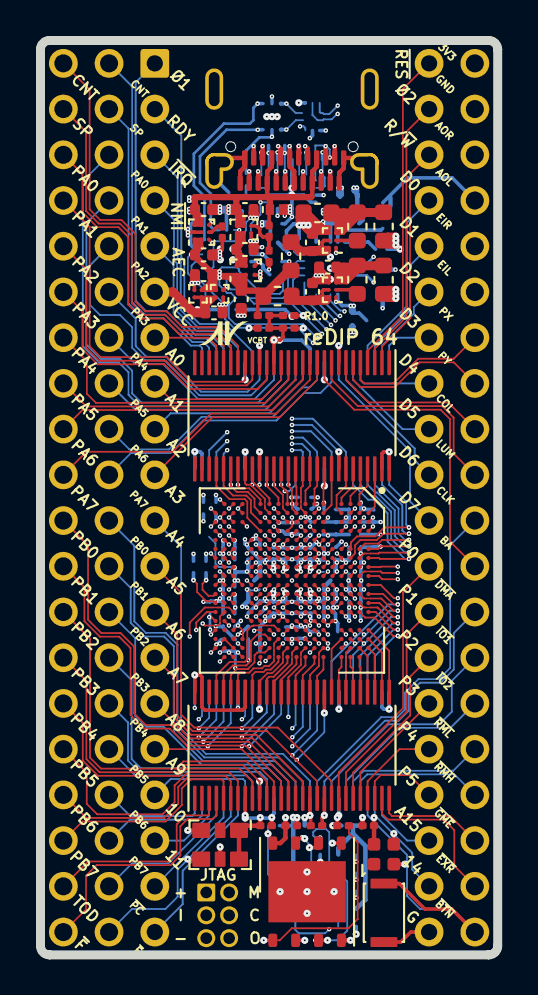
[picture p6: board reDIP-64.kicad_pcb from above]

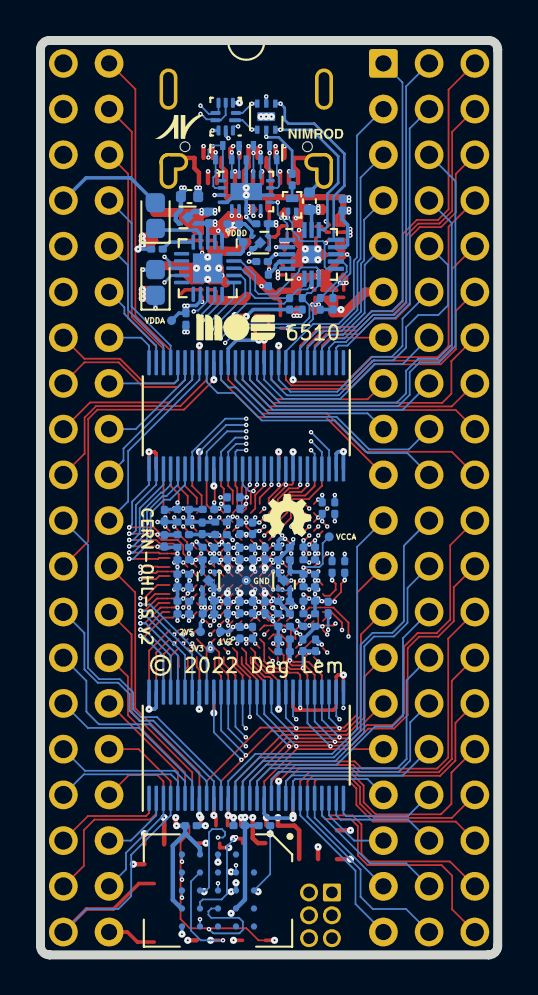
[picture p7: board reDIP-64.kicad_pcb from below]

Board: 6 copper layers, 25.4 x 50.8 mm, 150 parts (100 on the bottom side), 279 nets.

Other parts of the board:
OSHW logo: G***; OSHW-logo
svg2mod, svg2mod#3: G***; Nimrod-N-small
svg2mod#2: G***; Nimrod-text-small
svg2mod#4: G***; MOS-logo-small
