daglem/reDIP-64/(notices)

Notices in the files:
hardware/reDIP-64-Audio.kicad_sch:
© 2021-2022 Dag Lem
Licensed under CERN-OHL-S v2 (https://ohwr.org/cern_ohl_s_v2.txt)
hardware/reDIP-64.kicad_pcb:
CERN-OHL-S v2
© 2022 Dag Lem
